jayadamsmorgan/YKB-Dactyl-V1-PCB/README.md

# YKB Skadi KiCad PCB files

## Project setup

```bash
git clone https://github.com/jayadamsmorgan/ykb-skadi-pcb
cd ykb-skadi-pcb
git submodule init
git submodule update
```
