jayadamsmorgan/YKB-Dactyl-V1-PCB/thumb-board/thumb-board.kicad_pcb

## KiCad design thumb-board/thumb-board.kicad_pcb (2026-05-04)

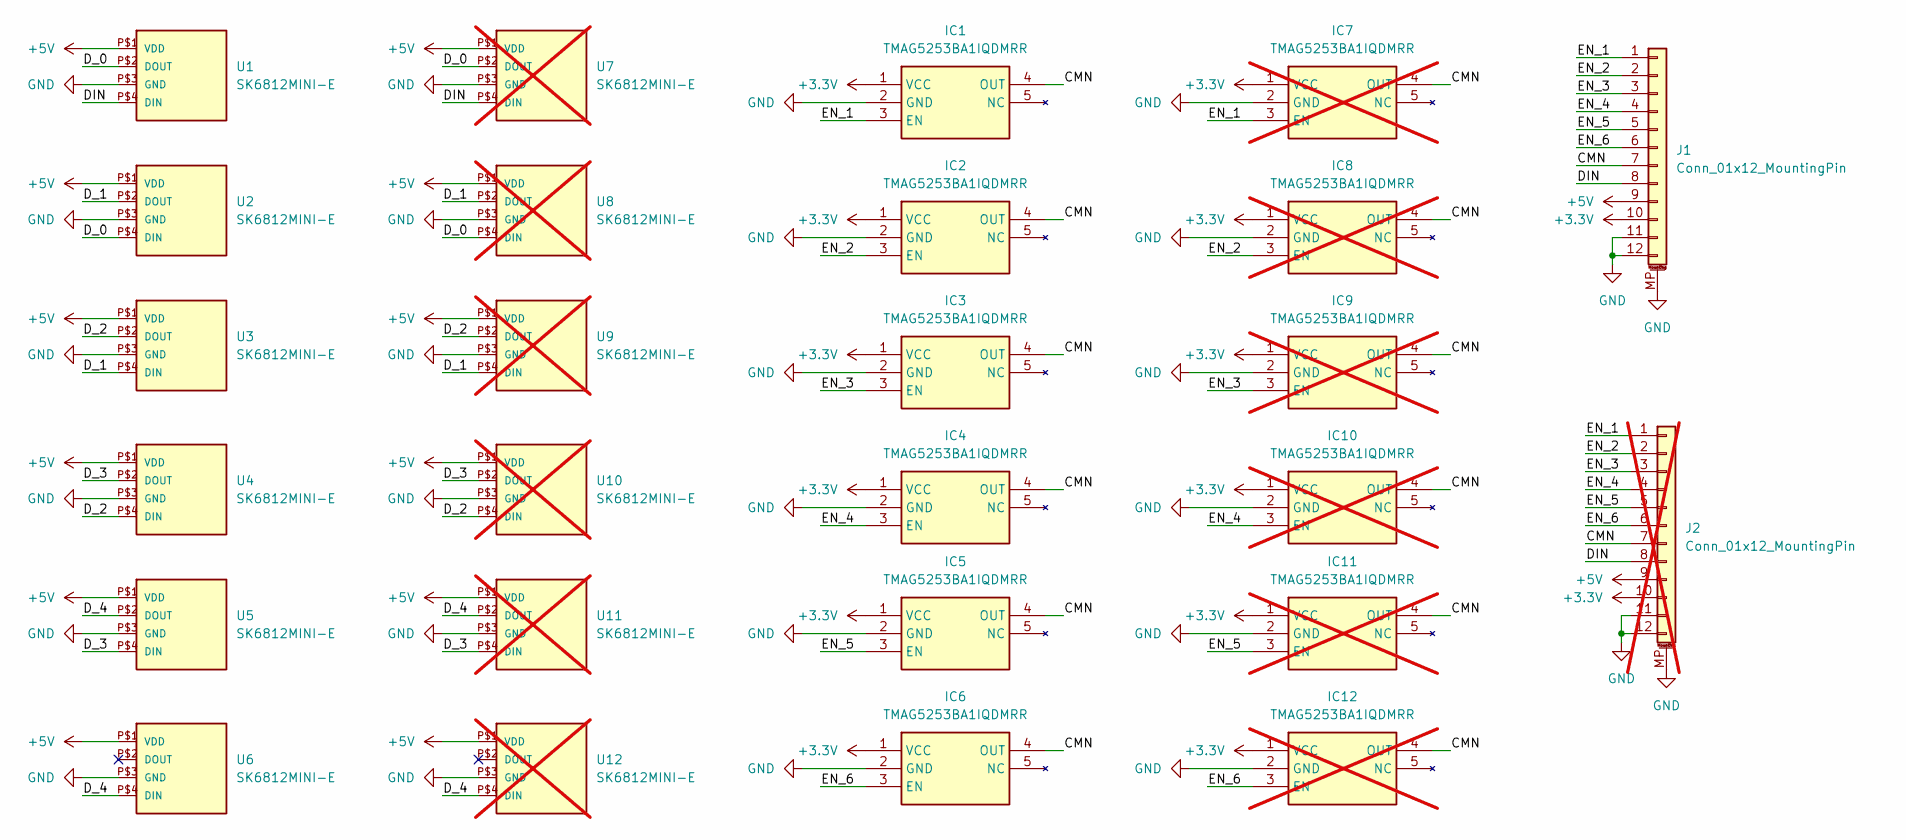
[picture p1: schematic thumb-board.kicad_sch]

Parts:
IC1, IC2, IC3, IC4, IC5, IC6: TMAG5253BA1IQDMRR; Mouser Part Number 595-TMAG5253BA1IQDMR
IC7, IC8, IC9, IC10, IC11, IC12: TMAG5253BA1IQDMRR; Mouser Part Number 595-TMAG5253BA1IQDMR; not fitted
J1: Conn_01x12_MountingPin; JST_SH_BM12B-SRSS-TB_1x12-1MP_P1.00mm_Vertical
J2: Conn_01x12_MountingPin; JST_SH_BM12B-SRSS-TB_1x12-1MP_P1.00mm_Vertical; not fitted
U1, U2, U3, U4, U5, U6: SK6812MINI-E
U7, U8, U9, U10, U11, U12: SK6812MINI-E; not fitted

Connections:
+3.3V: IC1.1 (VCC), IC2.1 (VCC), IC3.1 (VCC), IC4.1 (VCC), IC5.1 (VCC), IC6.1 (VCC), IC7.1 (VCC), IC8.1 (VCC), IC9.1 (VCC), IC10.1 (VCC), IC11.1 (VCC), IC12.1 (VCC), J1.10, J2.10
+5V: J1.9, J2.9, U1.P$1 (VDD), U2.P$1 (VDD), U3.P$1 (VDD), U4.P$1 (VDD), U5.P$1 (VDD), U6.P$1 (VDD), U7.P$1 (VDD), U8.P$1 (VDD), U9.P$1 (VDD), U10.P$1 (VDD), U11.P$1 (VDD), U12.P$1 (VDD)
/CMN: IC1.4 (OUT), IC2.4 (OUT), IC3.4 (OUT), IC4.4 (OUT), IC5.4 (OUT), IC6.4 (OUT), IC7.4 (OUT), IC8.4 (OUT), IC9.4 (OUT), IC10.4 (OUT), IC11.4 (OUT), IC12.4 (OUT), J1.7, J2.7
/DIN: J1.8, J2.8, U1.P$4 (DIN), U7.P$4 (DIN)
/D_0: U1.P$2 (DOUT), U2.P$4 (DIN), U7.P$2 (DOUT), U8.P$4 (DIN)
/D_1: U2.P$2 (DOUT), U3.P$4 (DIN), U8.P$2 (DOUT), U9.P$4 (DIN)
/D_2: U3.P$2 (DOUT), U4.P$4 (DIN), U9.P$2 (DOUT), U10.P$4 (DIN)
/D_3: U4.P$2 (DOUT), U5.P$4 (DIN), U10.P$2 (DOUT), U11.P$4 (DIN)
/D_4: U5.P$2 (DOUT), U6.P$4 (DIN), U11.P$2 (DOUT), U12.P$4 (DIN)
/EN_1: IC1.3 (EN), IC7.3 (EN), J1.1, J2.1
/EN_2: IC2.3 (EN), IC8.3 (EN), J1.2, J2.2
/EN_3: IC3.3 (EN), IC9.3 (EN), J1.3, J2.3
/EN_4: IC4.3 (EN), IC10.3 (EN), J1.4, J2.4
/EN_5: IC5.3 (EN), IC11.3 (EN), J1.5, J2.5
/EN_6: IC6.3 (EN), IC12.3 (EN), J1.6, J2.6
GND: IC1.2 (GND), IC2.2 (GND), IC3.2 (GND), IC4.2 (GND), IC5.2 (GND), IC6.2 (GND), IC7.2 (GND), IC8.2 (GND), IC9.2 (GND), IC10.2 (GND), IC11.2 (GND), IC12.2 (GND), J1.11, J1.12, J1.MP (MountPin), J2.11, J2.12, J2.MP (MountPin), U1.P$3 (GND), U2.P$3 (GND), U3.P$3 (GND), U4.P$3 (GND), U5.P$3 (GND), U6.P$3 (GND), U7.P$3 (GND), U8.P$3 (GND), U9.P$3 (GND), U10.P$3 (GND), U11.P$3 (GND), U12.P$3 (GND)

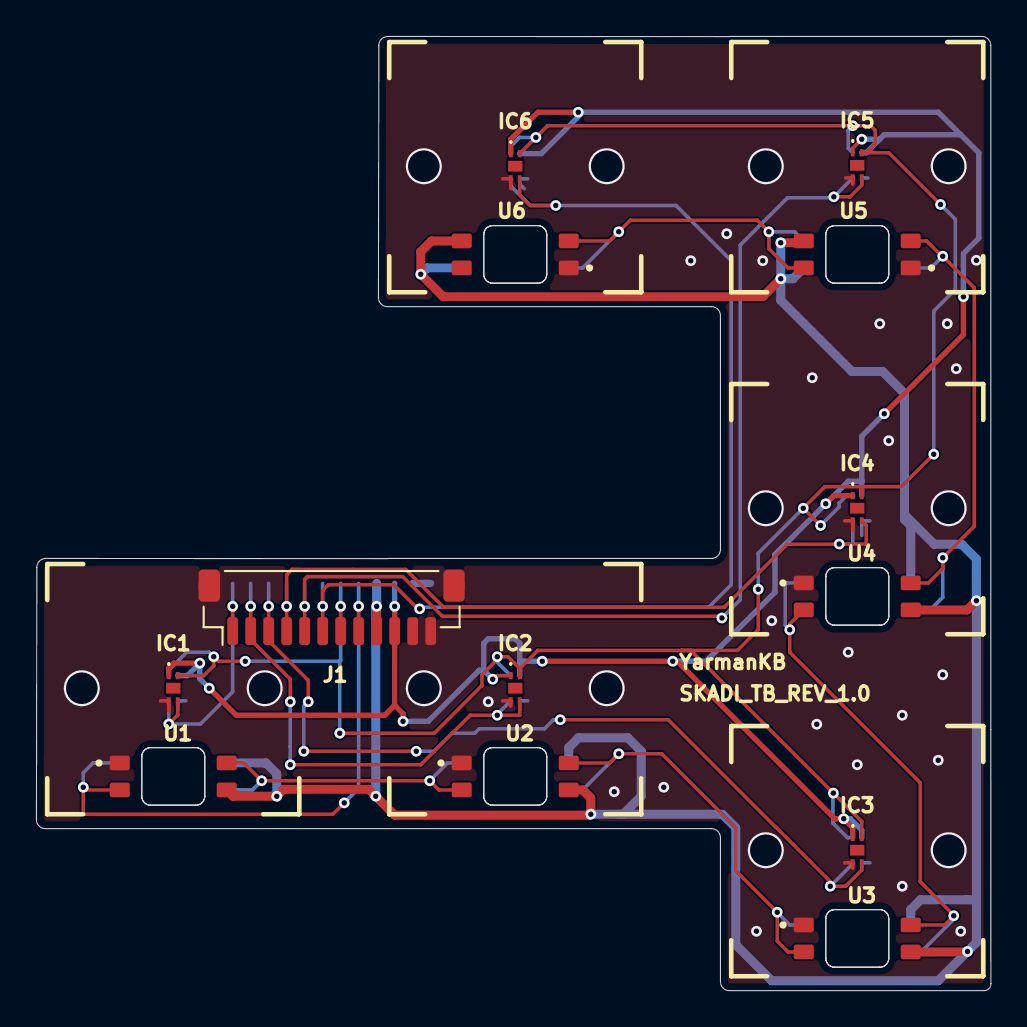
[picture p2: board thumb-board.kicad_pcb from above]

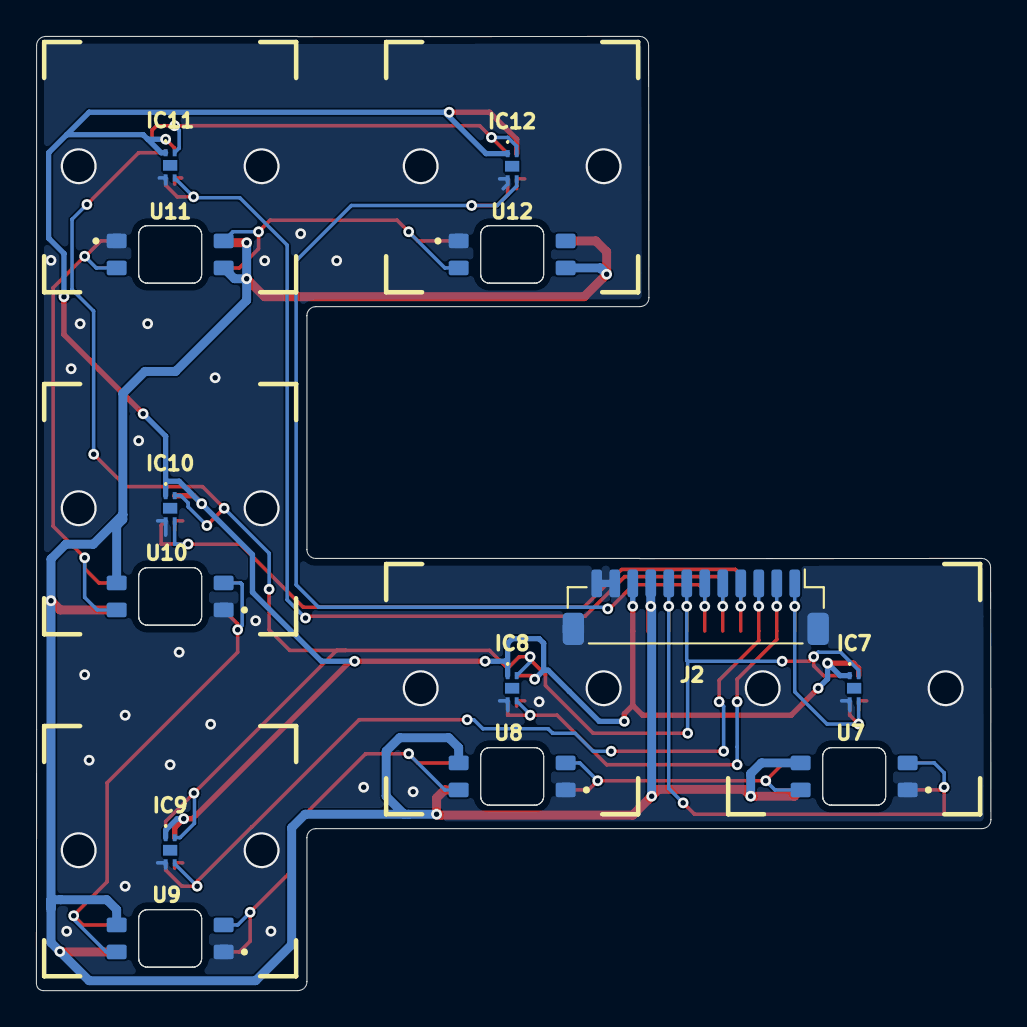
[picture p3: board thumb-board.kicad_pcb from below]

Board: 2 copper layers, 53.0 x 53.0 mm, 26 parts (13 on the bottom side), 16 nets.
