jayadamsmorgan/YKB-Dactyl-V1-PCB/finger-board/finger-board.kicad_pcb

## KiCad design finger-board/finger-board.kicad_pcb (2026-05-04)

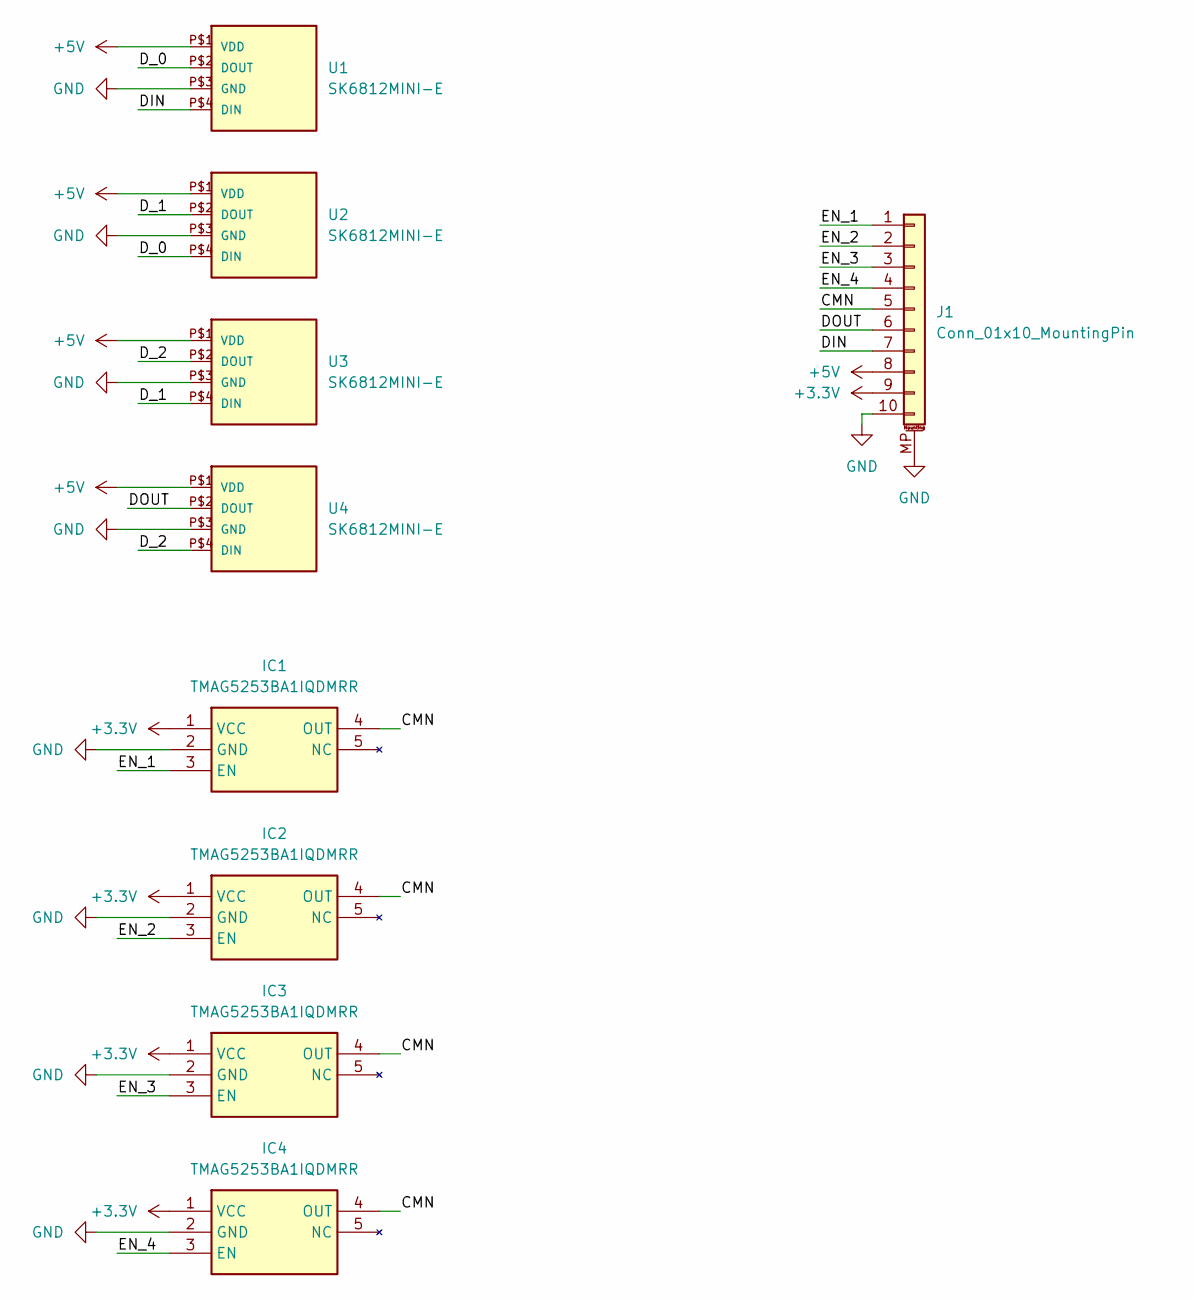
[picture p4: schematic finger-board.kicad_sch]

Parts:
IC1, IC2, IC3, IC4: TMAG5253BA1IQDMRR; Mouser Part Number 595-TMAG5253BA1IQDMR
J1: Conn_01x10_MountingPin; JST_SH_BM10B-SRSS-TB_1x10-1MP_P1.00mm_Vertical
U1, U2, U3, U4: SK6812MINI-E

Connections:
+3.3V: IC1.1 (VCC), IC2.1 (VCC), IC3.1 (VCC), IC4.1 (VCC), J1.9
+5V: J1.8, U1.P$1 (VDD), U2.P$1 (VDD), U3.P$1 (VDD), U4.P$1 (VDD)
/CMN: IC1.4 (OUT), IC2.4 (OUT), IC3.4 (OUT), IC4.4 (OUT), J1.5
/DIN: J1.7, U1.P$4 (DIN)
/DOUT: J1.6, U4.P$2 (DOUT)
/D_0: U1.P$2 (DOUT), U2.P$4 (DIN)
/D_1: U2.P$2 (DOUT), U3.P$4 (DIN)
/D_2: U3.P$2 (DOUT), U4.P$4 (DIN)
/EN_1: IC1.3 (EN), J1.1
/EN_2: IC2.3 (EN), J1.2
/EN_3: IC3.3 (EN), J1.3
/EN_4: IC4.3 (EN), J1.4
GND: IC1.2 (GND), IC2.2 (GND), IC3.2 (GND), IC4.2 (GND), J1.10, J1.MP (MountPin), U1.P$3 (GND), U2.P$3 (GND), U3.P$3 (GND), U4.P$3 (GND)

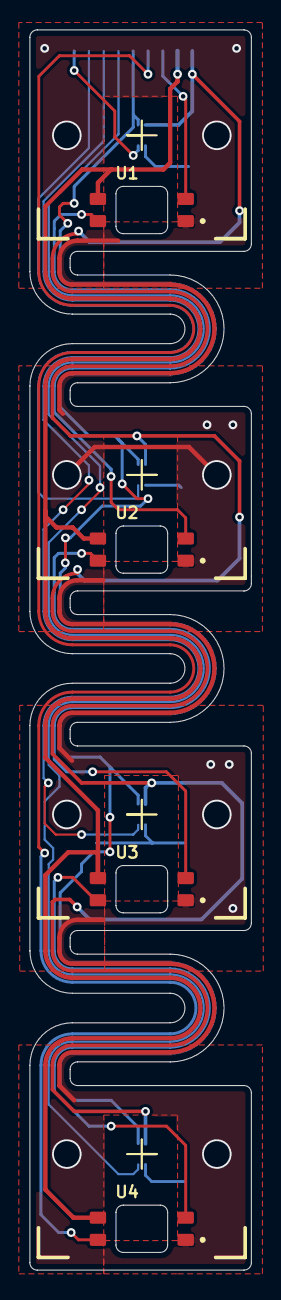
[picture p5: board finger-board.kicad_pcb from above]

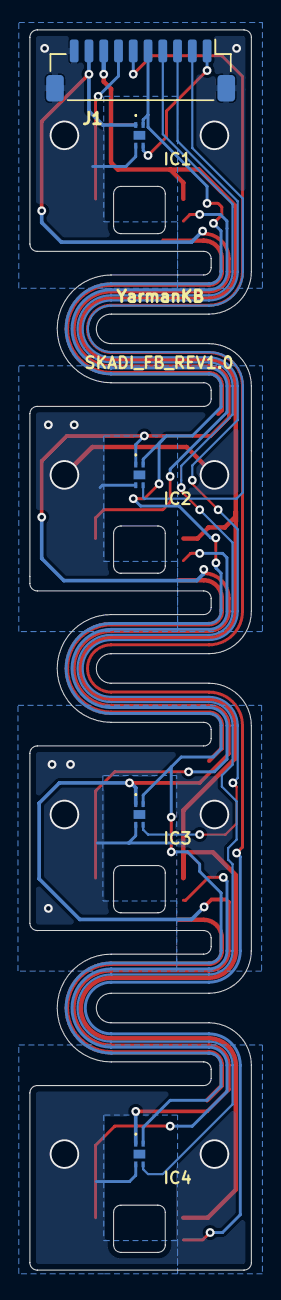
[picture p6: board finger-board.kicad_pcb from below]

Board: 2 copper layers, 15.0 x 84.0 mm, 9 parts (5 on the bottom side), 13 nets.
