jayadamsmorgan/YKB-Dactyl-V1-PCB/ykb-skadi-pcb.kicad_pcb

## KiCad design ykb-skadi-pcb.kicad_pcb (2026-05-04)

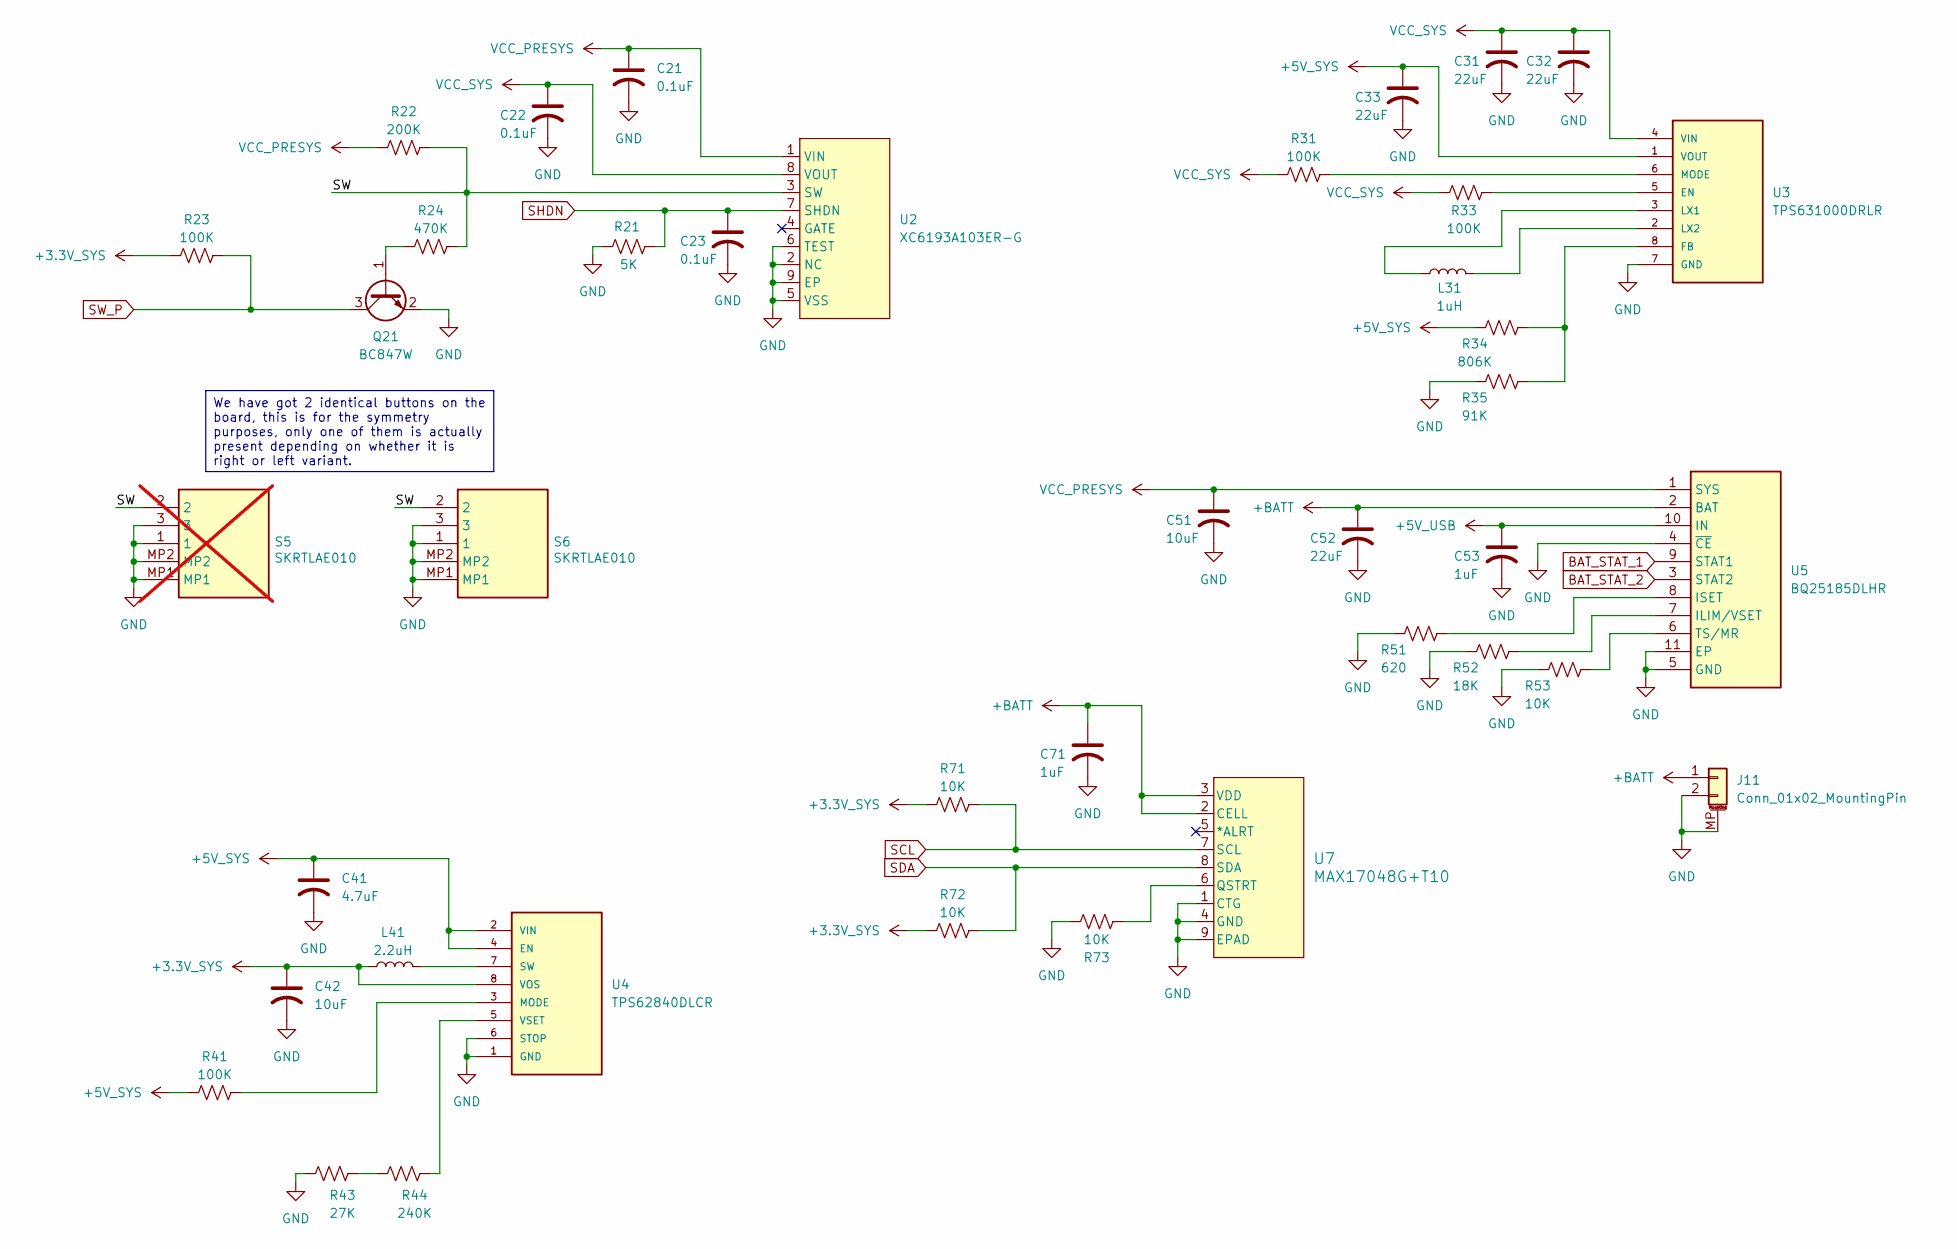
[picture p7: schematic power.kicad_sch]

Parts:
C21, C22, C23: 0.1uF; C_0402_1005Metric
C31, C32, C33, C52: 22uF; C_0402_1005Metric
C41: 4.7uF; C_0402_1005Metric
C42, C51: 10uF; C_0402_1005Metric
C53, C71: 1uF; C_0402_1005Metric
J11: Conn_01x02_MountingPin; JST_SHL_SM02B-SHLS-TF_1x02-1MP_P1.00mm_Horizontal
L31: 1uH; L_1008_2520Metric
L41: 2.2uH; L_Murata_DFE201610P
Q21: BC847W; SOT-323_SC-70
R21: 5K; R_0402_1005Metric
R22: 200K; R_0402_1005Metric
R23, R31, R33, R41: 100K; R_0402_1005Metric
R24: 470K; R_0402_1005Metric
R34: 806K; R_0402_1005Metric
R35: 91K; R_0402_1005Metric
R43: 27K; R_0402_1005Metric
R44: 240K; R_0402_1005Metric
R51: 620; R_0402_1005Metric
R52: 18K; R_0402_1005Metric
R53, R71, R72, R73: 10K; R_0402_1005Metric
S5: SKRTLAE010; Mouser Part Number 688-SKRTLA; not fitted
S6: SKRTLAE010; Mouser Part Number 688-SKRTLA
U2: XC6193A103ER-G; USP-8B06
U3: TPS631000DRLR; SOT50P160X60-8N; PARTREV B
U4: TPS62840DLCR; SON50P200X150X100-8N
U5: BQ25185DLHR; SON40P220X200X80-11N; Mouser Part Number 595-BQ25185DLHR
U7: MAX17048G+T10; 21-0168E_T822-3_MXM

Connections:
+3.3V_SYS: C42.1, L41.1, R23.2, R71.2, R72.2, U4.8 (VOS); also elsewhere on the board
+5V_SYS: C33.1, C41.1, R34.2, R41.2, U3.1 (VOUT), U4.2 (VIN), U4.4 (EN); also elsewhere on the board
+5V_USB: C53.1, U5.10 (IN); also elsewhere on the board
+BATT: C52.1, C71.1, J11.1, U5.2 (BAT), U7.2 (CELL), U7.3 (VDD)
/Power/SW: R22.1, R24.1, S5.2, S6.2, U2.3 (SW)
BAT_STAT_1: U5.9 (STAT1); also elsewhere on the board
BAT_STAT_2: U5.3 (STAT2); also elsewhere on the board
GND: C21.2, C22.2, C23.2, C31.2, C32.2, C33.2, C41.2, C42.2, C51.2, C52.2, C53.2, C71.2, J11.2, J11.MP (MountPin), Q21.2 (E), R21.2, R35.2, R43.2, R51.2, R52.2, R53.2, R73.1, S5.1, S5.3, S5.MP1, S5.MP2, S6.1, S6.3, S6.MP1, S6.MP2, U2.2 (NC), U2.5 (VSS), U2.6 (TEST), U2.9 (EP), U3.7 (GND), U4.1 (GND), U4.6 (STOP), U5.4 (~CE), U5.5 (GND), U5.11 (EP), U7.1 (CTG), U7.4 (GND), U7.9 (EPAD); also elsewhere on the board
unnamed: Q21.1 (B), R24.2
unnamed: R43.1, R44.2
unnamed: R33.1, U3.5 (EN)
unnamed: R34.1, R35.1, U3.8 (FB)
unnamed: L31.1, U3.3 (LX1)
unnamed: L31.2, U3.2 (LX2)
unnamed: R31.1, U3.6 (MODE)
unnamed: R41.1, U4.3 (MODE)
unnamed: L41.2, U4.7 (SW)
unnamed: R44.1, U4.5 (VSET)
unnamed: R52.1, U5.7 (ILIM/VSET)
unnamed: R51.1, U5.8 (ISET)
unnamed: R53.1, U5.6 (TS/MR)
unnamed: R73.2, U7.6 (QSTRT)
SCL: R71.1, U7.7 (SCL); also elsewhere on the board
SDA: R72.1, U7.8 (SDA); also elsewhere on the board
SHDN: C23.1, R21.1, U2.7 (SHDN); also elsewhere on the board
SW_P: Q21.3 (C), R23.1; also elsewhere on the board
VCC_PRESYS: C21.1, C51.1, R22.2, U2.1 (VIN), U5.1 (SYS); also elsewhere on the board
VCC_SYS: C22.1, C31.1, C32.1, R31.2, R33.2, U2.8 (VOUT), U3.4 (VIN)

Notes on the sheet:
We have got 2 identical buttons on the board, this is for the symmetry purposes, only one of them is actually present depending on whether it is right or left variant.

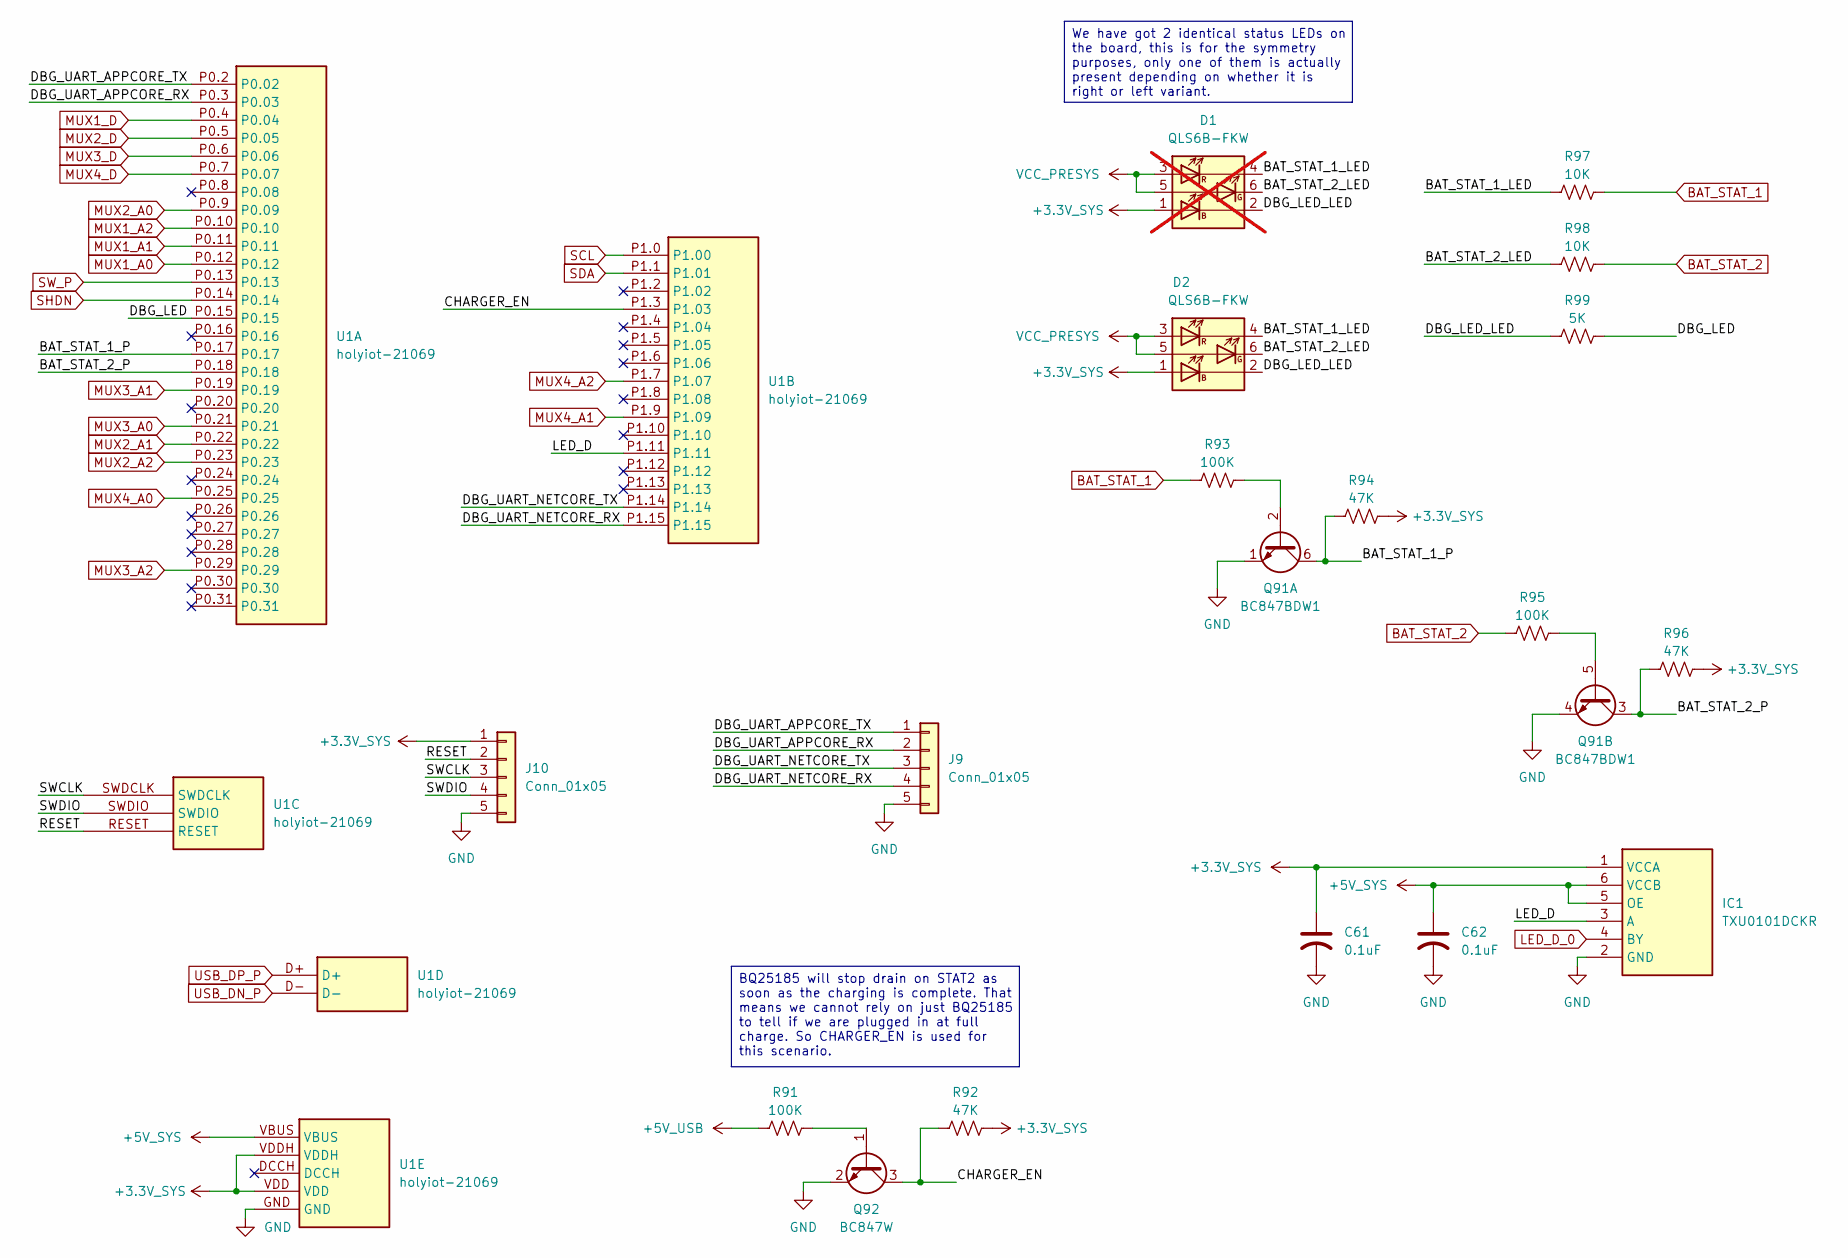
[picture p8: schematic mcu.kicad_sch]

Parts:
C61, C62: 0.1uF; C_0402_1005Metric
D1: QLS6B-FKW; LED_Cree-PLCC6_4.7x1.5mm; not fitted
D2: QLS6B-FKW; LED_Cree-PLCC6_4.7x1.5mm
IC1: TXU0101DCKR; SOT65P210X110-6N; Mouser Part Number 595-TXU0101DCKR
J9, J10: Conn_01x05; PinSocket_1x05_P2.54mm_Vertical
Q91: BC847BDW1; SOT-363_SC-70-6
Q92: BC847W; SOT-323_SC-70
R91, R93, R95: 100K; R_0402_1005Metric
R92, R94, R96: 47K; R_0402_1005Metric
R97, R98: 10K; R_0402_1005Metric
R99: 5K; R_0402_1005Metric
U1: holyiot-21069

Connections:
+3.3V_SYS: C61.1, D1.1 (AB), D2.1 (AB), IC1.1 (VCCA), J10.1, R92.1, R94.1, R96.1, U1.VDD, U1.VDDH; also elsewhere on the board
+5V_SYS: C62.1, IC1.5 (OE), IC1.6 (VCCB), U1.VBUS; also elsewhere on the board
+5V_USB: R91.2; also elsewhere on the board
/MCU/BAT_STAT_1_LED: D1.4 (KR), D2.4 (KR), R97.2
/MCU/BAT_STAT_1_P: Q91.6 (C1), R94.2, U1.P0.17
/MCU/BAT_STAT_2_LED: D1.6 (KR), D2.6 (KR), R98.2
/MCU/BAT_STAT_2_P: Q91.3 (C2), R96.2, U1.P0.18
/MCU/CHARGER_EN: Q92.3 (C), R92.2, U1.P1.3 (P1.03)
/MCU/DBG_LED: R99.1, U1.P0.15
/MCU/DBG_LED_LED: D1.2 (KB), D2.2 (KB), R99.2
/MCU/DBG_UART_APPCORE_RX: J9.2, U1.P0.3 (P0.03)
/MCU/DBG_UART_APPCORE_TX: J9.1, U1.P0.2 (P0.02)
/MCU/DBG_UART_NETCORE_RX: J9.4, U1.P1.15
/MCU/DBG_UART_NETCORE_TX: J9.3, U1.P1.14
/MCU/LED_D: IC1.3 (A), U1.P1.11
/MCU/RESET: J10.2, U1.RESET
/MCU/SWCLK: J10.3, U1.SWDCLK
/MCU/SWDIO: J10.4, U1.SWDIO
BAT_STAT_1: R93.2, R97.1; also elsewhere on the board
BAT_STAT_2: R95.2, R98.1; also elsewhere on the board
GND: C61.2, C62.2, IC1.2 (GND), J9.5, J10.5, Q91.1 (E1), Q91.4 (E2), Q92.2 (E), U1.GND; also elsewhere on the board
LED_D_0: IC1.4 (BY); also elsewhere on the board
MUX1_A0: U1.P0.12; also elsewhere on the board
MUX1_A1: U1.P0.11; also elsewhere on the board
MUX1_A2: U1.P0.10; also elsewhere on the board
MUX1_D: U1.P0.4 (P0.04); also elsewhere on the board
MUX2_A0: U1.P0.9 (P0.09); also elsewhere on the board
MUX2_A1: U1.P0.22; also elsewhere on the board
MUX2_A2: U1.P0.23; also elsewhere on the board
MUX2_D: U1.P0.5 (P0.05); also elsewhere on the board
MUX3_A0: U1.P0.21; also elsewhere on the board
MUX3_A1: U1.P0.19; also elsewhere on the board
MUX3_A2: U1.P0.29; also elsewhere on the board
MUX3_D: U1.P0.6 (P0.06); also elsewhere on the board
MUX4_A0: U1.P0.25; also elsewhere on the board
MUX4_A1: U1.P1.9 (P1.09); also elsewhere on the board
MUX4_A2: U1.P1.7 (P1.07); also elsewhere on the board
MUX4_D: U1.P0.7 (P0.07); also elsewhere on the board
unnamed: Q91.2 (B1), R93.1
unnamed: Q91.5 (B2), R95.1
unnamed: Q92.1 (B), R91.1
SCL: U1.P1.0 (P1.00); also elsewhere on the board
SDA: U1.P1.1 (P1.01); also elsewhere on the board
SHDN: U1.P0.14; also elsewhere on the board
SW_P: U1.P0.13; also elsewhere on the board
USB_DN_P: U1.D-; also elsewhere on the board
USB_DP_P: U1.D+; also elsewhere on the board
VCC_PRESYS: D1.3 (AR), D1.5 (AG), D2.3 (AR), D2.5 (AG); also elsewhere on the board

Notes on the sheet:
We have got 2 identical status LEDs on the board, this is for the symmetry purposes, only one of them is actually present depending on whether it is right or left variant.
BQ25185 will stop drain on STAT2 as soon as the charging is complete. That means we cannot rely on just BQ25185 to tell if we are plugged in at full charge. So CHARGER_EN is used for this scenario.

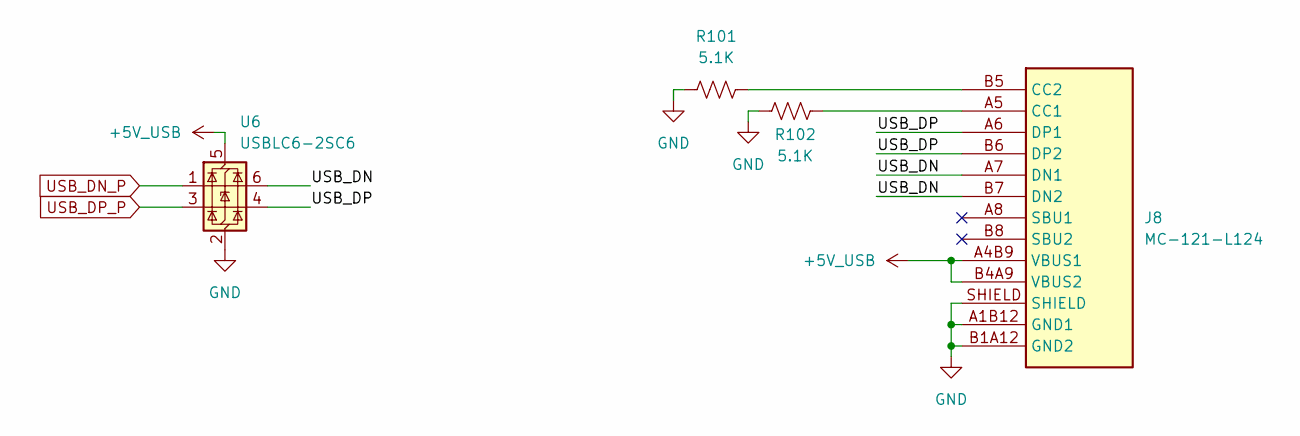
[picture p9: schematic usb.kicad_sch]

Parts:
J8: MC-121-L124
R101, R102: 5.1K; R_0402_1005Metric
U6: USBLC6-2SC6; SOT-23-6

Connections:
+5V_USB: J8.A4B9 (VBUS1), J8.B4A9 (VBUS2), U6.5 (VBUS); also elsewhere on the board
/USB/USB_DN: J8.A7 (DN1), J8.B7 (DN2), U6.6 (I/O1)
/USB/USB_DP: J8.A6 (DP1), J8.B6 (DP2), U6.4 (I/O2)
GND: J8.A1B12 (GND1), J8.B1A12 (GND2), J8.SHIELD, R101.2, R102.2, U6.2 (GND); also elsewhere on the board
unnamed: J8.A5 (CC1), R102.1
unnamed: J8.B5 (CC2), R101.1
USB_DN_P: U6.1 (I/O1); also elsewhere on the board
USB_DP_P: U6.3 (I/O2); also elsewhere on the board

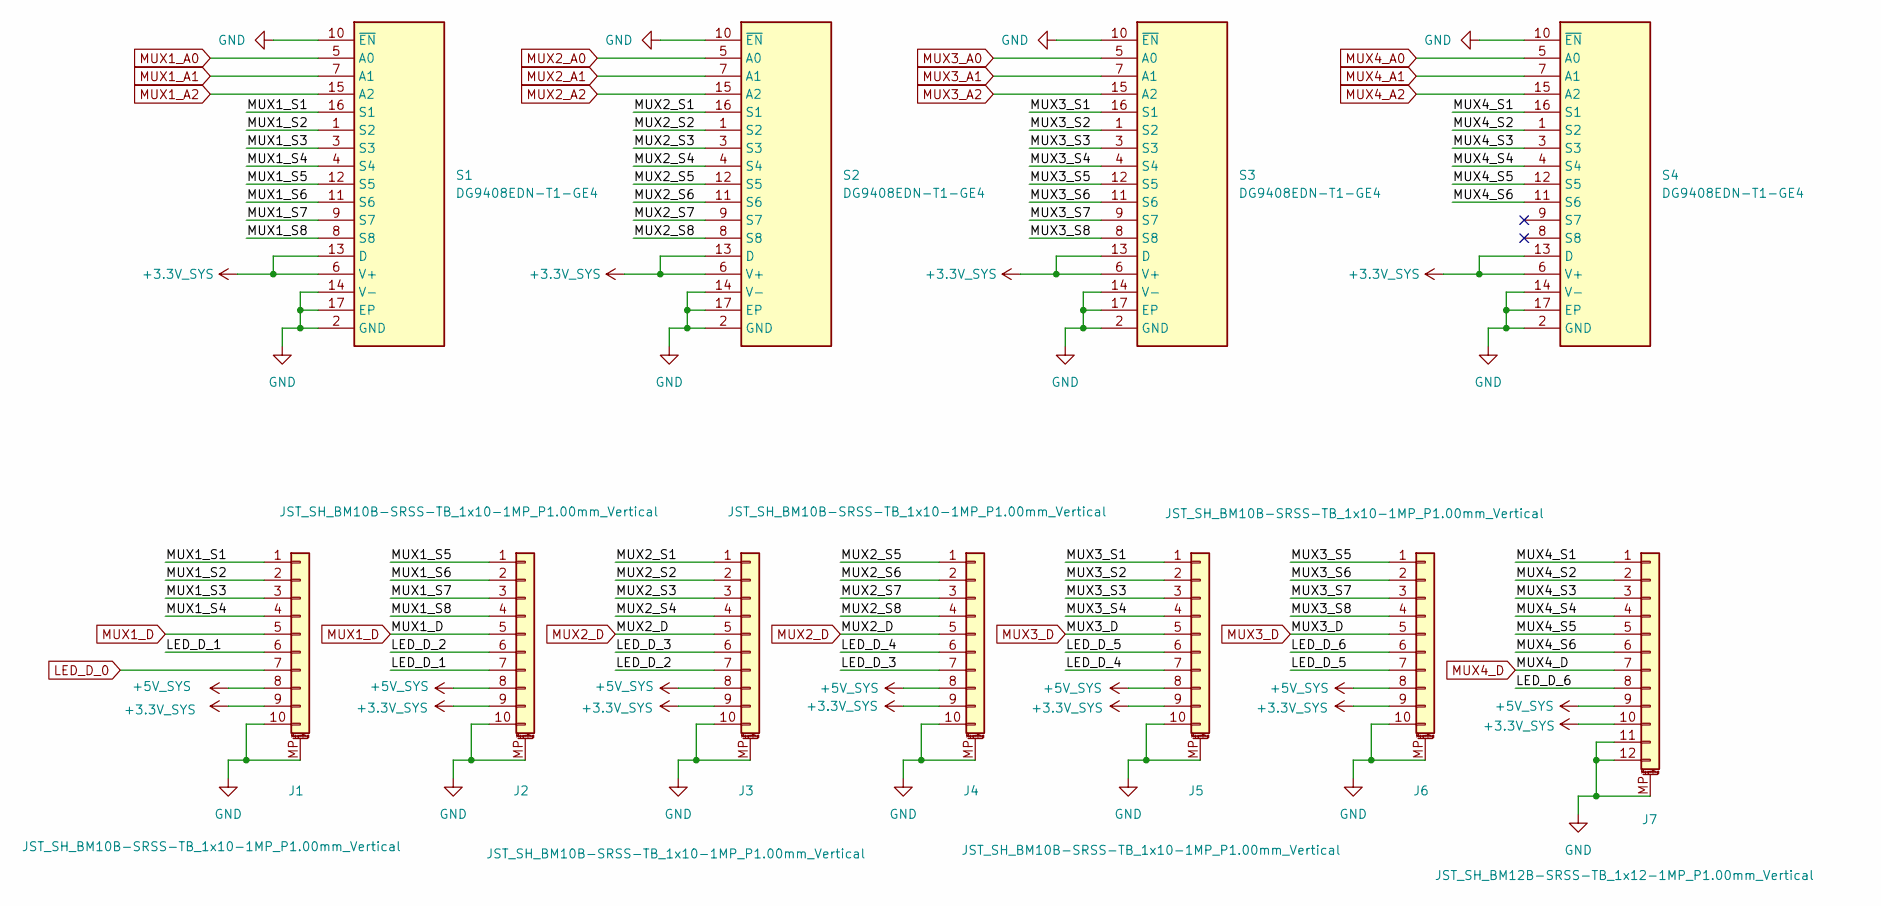
[picture p10: schematic muxes.kicad_sch]

Parts:
J1, J2, J3, J4, J5, J6: JST_SH_BM10B-SRSS-TB_1x10-1MP_P1.00mm_Vertical
J7: JST_SH_BM12B-SRSS-TB_1x12-1MP_P1.00mm_Vertical
S1, S2, S3, S4: DG9408EDN-T1-GE4; QFN65P400X400X95-17N-D; Mouser Part Number 78-DG9408EDN-T1-GE4

Connections:
+3.3V_SYS: J1.9, J2.9, J3.9, J4.9, J5.9, J6.9, J7.10, S1.6 (V+), S1.13 (D), S2.6 (V+), S2.13 (D), S3.6 (V+), S3.13 (D), S4.6 (V+), S4.13 (D); also elsewhere on the board
+5V_SYS: J1.8, J2.8, J3.8, J4.8, J5.8, J6.8, J7.9; also elsewhere on the board
/MUXes/LED_D_1: J1.6, J2.7
/MUXes/LED_D_2: J2.6, J3.7
/MUXes/LED_D_3: J3.6, J4.7
/MUXes/LED_D_4: J4.6, J5.7
/MUXes/LED_D_5: J5.6, J6.7
/MUXes/LED_D_6: J6.6, J7.8
/MUXes/MUX1_S1: J1.1, S1.16 (S1)
/MUXes/MUX1_S2: J1.2, S1.1 (S2)
/MUXes/MUX1_S3: J1.3, S1.3 (S3)
/MUXes/MUX1_S4: J1.4, S1.4 (S4)
/MUXes/MUX1_S5: J2.1, S1.12 (S5)
/MUXes/MUX1_S6: J2.2, S1.11 (S6)
/MUXes/MUX1_S7: J2.3, S1.9 (S7)
/MUXes/MUX1_S8: J2.4, S1.8 (S8)
/MUXes/MUX2_S1: J3.1, S2.16 (S1)
/MUXes/MUX2_S2: J3.2, S2.1 (S2)
/MUXes/MUX2_S3: J3.3, S2.3 (S3)
/MUXes/MUX2_S4: J3.4, S2.4 (S4)
/MUXes/MUX2_S5: J4.1, S2.12 (S5)
/MUXes/MUX2_S6: J4.2, S2.11 (S6)
/MUXes/MUX2_S7: J4.3, S2.9 (S7)
/MUXes/MUX2_S8: J4.4, S2.8 (S8)
/MUXes/MUX3_S1: J5.1, S3.16 (S1)
/MUXes/MUX3_S2: J5.2, S3.1 (S2)
/MUXes/MUX3_S3: J5.3, S3.3 (S3)
/MUXes/MUX3_S4: J5.4, S3.4 (S4)
/MUXes/MUX3_S5: J6.1, S3.12 (S5)
/MUXes/MUX3_S6: J6.2, S3.11 (S6)
/MUXes/MUX3_S7: J6.3, S3.9 (S7)
/MUXes/MUX3_S8: J6.4, S3.8 (S8)
/MUXes/MUX4_S1: J7.1, S4.16 (S1)
/MUXes/MUX4_S2: J7.2, S4.1 (S2)
/MUXes/MUX4_S3: J7.3, S4.3 (S3)
/MUXes/MUX4_S4: J7.4, S4.4 (S4)
/MUXes/MUX4_S5: J7.5, S4.12 (S5)
/MUXes/MUX4_S6: J7.6, S4.11 (S6)
GND: J1.10, J1.MP (MountPin), J2.10, J2.MP (MountPin), J3.10, J3.MP (MountPin), J4.10, J4.MP (MountPin), J5.10, J5.MP (MountPin), J6.10, J6.MP (MountPin), J7.11, J7.12, J7.MP (MountPin), S1.2 (GND), S1.10 (~EN), S1.14 (V-), S1.17 (EP), S2.2 (GND), S2.10 (~EN), S2.14 (V-), S2.17 (EP), S3.2 (GND), S3.10 (~EN), S3.14 (V-), S3.17 (EP), S4.2 (GND), S4.10 (~EN), S4.14 (V-), S4.17 (EP); also elsewhere on the board
LED_D_0: J1.7; also elsewhere on the board
MUX1_A0: S1.5 (A0); also elsewhere on the board
MUX1_A1: S1.7 (A1); also elsewhere on the board
MUX1_A2: S1.15 (A2); also elsewhere on the board
MUX1_D: J1.5, J2.5; also elsewhere on the board
MUX2_A0: S2.5 (A0); also elsewhere on the board
MUX2_A1: S2.7 (A1); also elsewhere on the board
MUX2_A2: S2.15 (A2); also elsewhere on the board
MUX2_D: J3.5, J4.5; also elsewhere on the board
MUX3_A0: S3.5 (A0); also elsewhere on the board
MUX3_A1: S3.7 (A1); also elsewhere on the board
MUX3_A2: S3.15 (A2); also elsewhere on the board
MUX3_D: J5.5, J6.5; also elsewhere on the board
MUX4_A0: S4.5 (A0); also elsewhere on the board
MUX4_A1: S4.7 (A1); also elsewhere on the board
MUX4_A2: S4.15 (A2); also elsewhere on the board
MUX4_D: J7.7; also elsewhere on the board

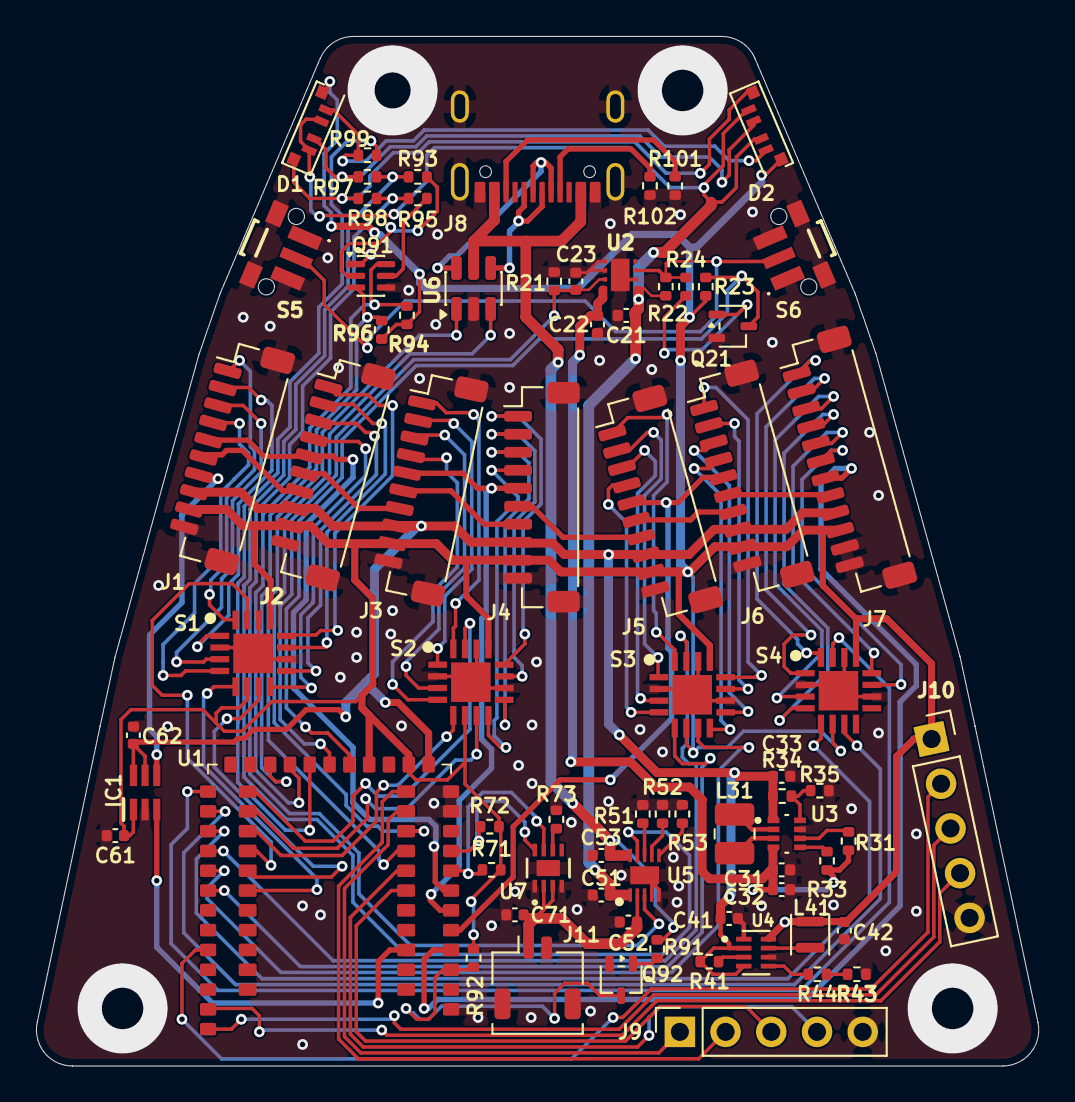
[picture p11: board ykb-skadi-pcb.kicad_pcb from above]

Board: 2 copper layers, 55.7 x 57.2 mm, 74 parts (0 on the bottom side), 105 nets.
