jayadamsmorgan/YKB-Dactyl-V1-PCB/(commit log)

2026-02-18 Modify placment of component
    [ykb-dactyl-v1.kicad_pcb]
2026-02-25 Add finger-board & thumb-board
    [finger-board.kicad_pcb, finger-board.kicad_sch, thumb-board.kicad_pcb, thumb-board.kicad_sch]
2026-02-26 Update kicad_lib
2026-02-26 Trace thumb-board
    [thumb-board.kicad_pcb]
2026-03-01 Trace finger-board
    [finger-board.kicad_pcb]
2026-03-01 Update silkscreen text
    [thumb-board.kicad_pcb]
2026-03-03 Fix board shape
    [ykb-dactyl-v1.kicad_pcb]
2026-03-03 Fix global nets
    [mcu.kicad_sch, muxes.kicad_sch, power.kicad_sch, usb.kicad_sch, ykb-dactyl-v1.kicad_pcb]
2026-03-04 Place components
    [power.kicad_sch, ykb-dactyl-v1.kicad_pcb]
2026-03-17 Move SK6812 a bit down on daughter boards
    [finger-board.kicad_pcb, thumb-board.kicad_pcb]
2026-03-21 Trace the board
    [mcu.kicad_sch, muxes.kicad_sch, power.kicad_sch, ykb-dactyl-v1.kicad_pcb]
2026-03-21 Change PCB thickness to 1mm
    [ykb-dactyl-v1.kicad_pcb]
2026-03-22 Change board thickness
    [ykb-dactyl-v1.kicad_pcb]
2026-03-22 Add first version to the silkscreen
    [ykb-dactyl-v1.kicad_pcb]
2026-04-11 Developer Preview 1
    [finger-board.kicad_pcb, finger-board.kicad_sch, mcu.kicad_sch, muxes.kicad_sch, power.kicad_sch, thumb-board.kicad_pcb, thumb-board.kicad_sch, usb.kicad_sch]
2026-04-22 Developer Preview 2
    [mcu.kicad_sch, power.kicad_sch, ykb-dactyl-v1.kicad_pcb]
2026-04-22 Fix silkscreen for Developer Preview 2
    [ykb-dactyl-v1.kicad_pcb]
2026-04-22 Tweak R23 and R24 values
    [power.kicad_sch]
2026-04-23 Refill zones
    [ykb-dactyl-v1.kicad_pcb]
2026-05-04 Rename the board to Skadi
    [finger-board.kicad_pcb, mcu.kicad_sch, muxes.kicad_sch, power.kicad_sch, thumb-board.kicad_pcb, usb.kicad_sch, ykb-skadi-pcb.kicad_pcb, ykb-skadi-pcb.kicad_sch]
